wagiminator/CH32V003-IR-Remote/hardware/IR_Remote_BOM.tsv

ID | Name | Designator | Footprint | Quantity | Manufacturer Part | Manufacturer | Supplier | Supplier Part
1 | CR2032-BS-6-1 | B1 | BATTERY-3 | 1 | CR2032-BS-6-1 | Q&J | LCSC | C70377
2 | 100n | C1 | C_0603 | 1 | CC0603KRX7R9BB104 | YAGEO | LCSC | C14663
3 | SWIO | H1 | 210S-3X1/2.54 | 1 | Header2.54mm 1*3P | BOOMELE | LCSC | C49257
4 | SMD Tactile Switch6*6*6mm | KEY1,KEY2,KEY3,KEY4,KEY5 | KEY-6.0*6.0 | 5 | SMD Tactile Switch6*6*6mm | ReliaPro | LCSC | C23873
5 | IR333-A | LED1 | LED-5MM/2.54 | 1 | IR333-A | Everlight Elec | LCSC | C264290
6 | IR333C/H0/L10 | LED2 | LED-5MM/2.54 | 1 | IR333C/H0/L10 | EVERLIGHT | LCSC | C72053
7 | 22R | R1,R2 | 0603 | 2 | 0603WAF220JT5E | UNI-ROYAL(厚声) | LCSC | C23345
8 | CH32V003J4M6 | U1 | SOP-8_150MIL | 1 | CH32V003J4M6 | WCH(Jiangsu Qin Heng) | LCSC | C5346354
