wagiminator/CH32V003-IR-Remote/3dprint/IR_Remote_lid.stl

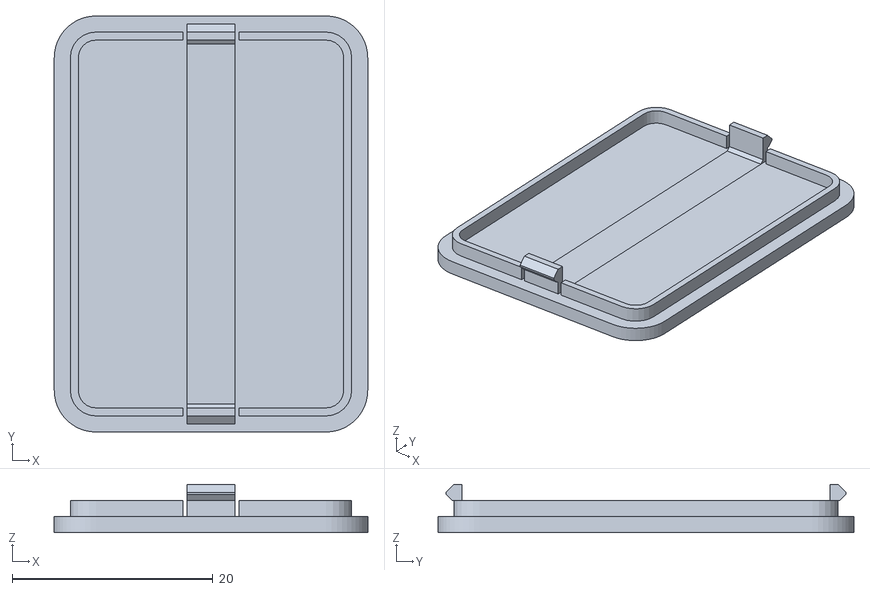
[picture p7: CAD file, 2024-07-31]
3dprint/IR_Remote_lid.stl
31.2 x 41.4 x 4.80
