wagiminator/CH32V003-IR-Remote/3dprint/IR_Remote.fcstd

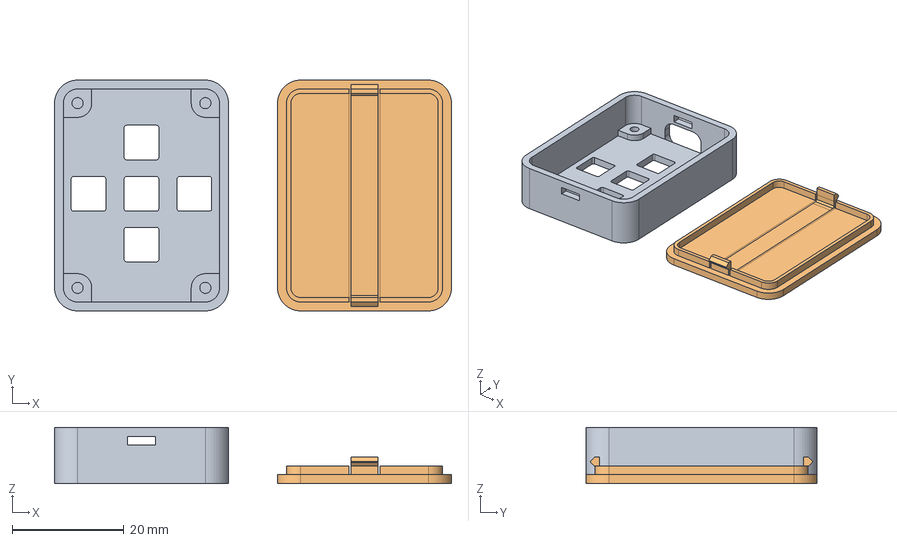
[picture p8: CAD file, 2024-07-31]
3dprint/IR_Remote.fcstd
71.2 x 41.4 x 10.1 mm
Case
Lid
