wagiminator/CH32V003-IR-Remote/3dprint/IR_Remote_case.stl

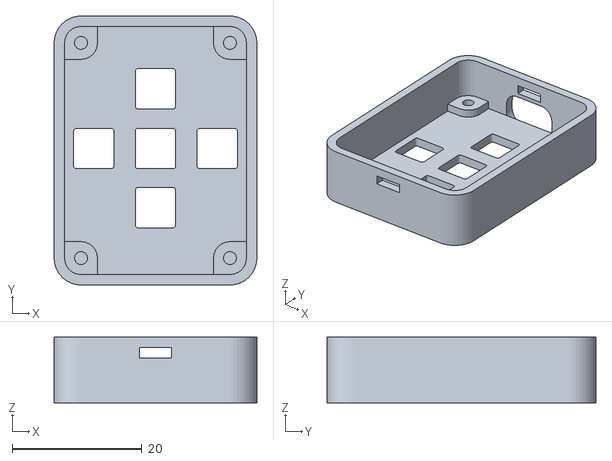
[picture p9: CAD file, 2024-07-31]
3dprint/IR_Remote_case.stl
31.2 x 41.4 x 10.1
