wagiminator/CH32V003-IR-Remote/hardware/IR_Remote_schematic.pdf

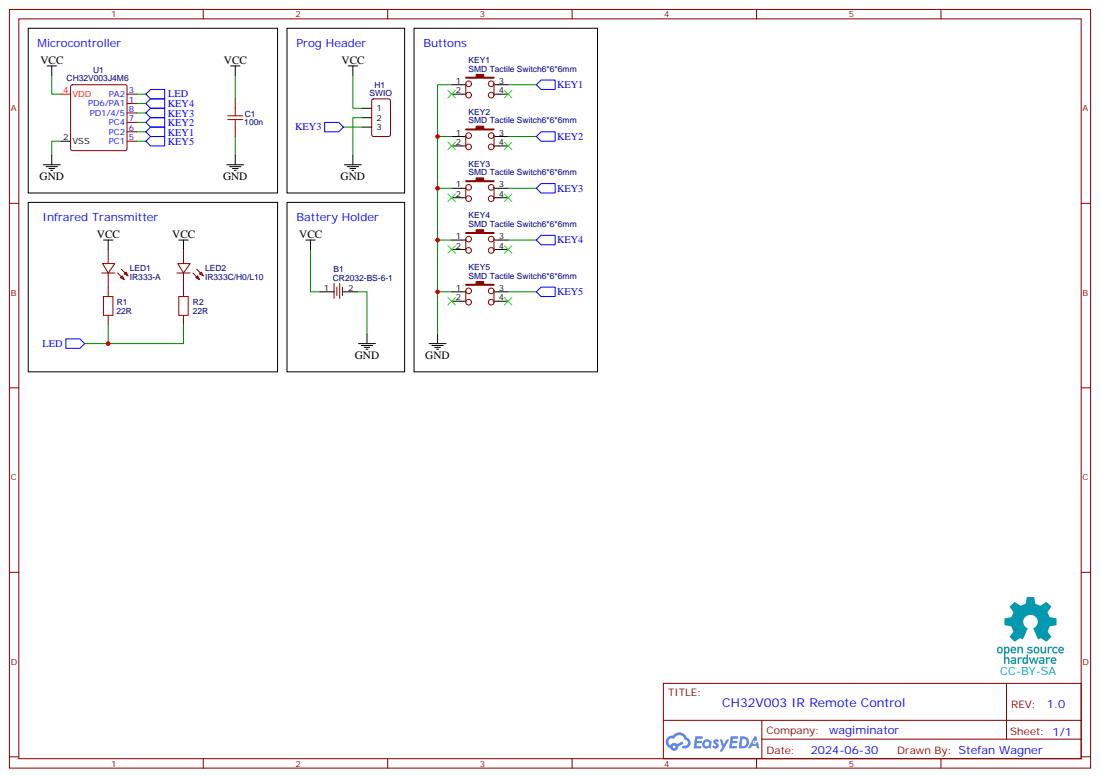
[picture p10: page 1]

Drawn By: Stefan Wagner
