wagiminator/CH32V003-IR-Remote/(threads)

Thread 1 (2024-08-01):

Porting to CH582/CH583

happytm, 2024-08-01:
Nice project.

How hard it will be to port this code to CH582/CH583 micro controllers with built in BLE?

The purpose of porting would be to change IR codes in config file using BLE without recompiling the code.

Thanks.

wagiminator, 2024-08-03:
I have never dealt with the CH582/CH583 before. But basically, it is as simple as described: PWM for the carrier wave and then turning the pin on and off with the appropriate delays in between.
